myuzrilib/IndustrialDefectCPS-YOLOv8/hardware/station_layout.png

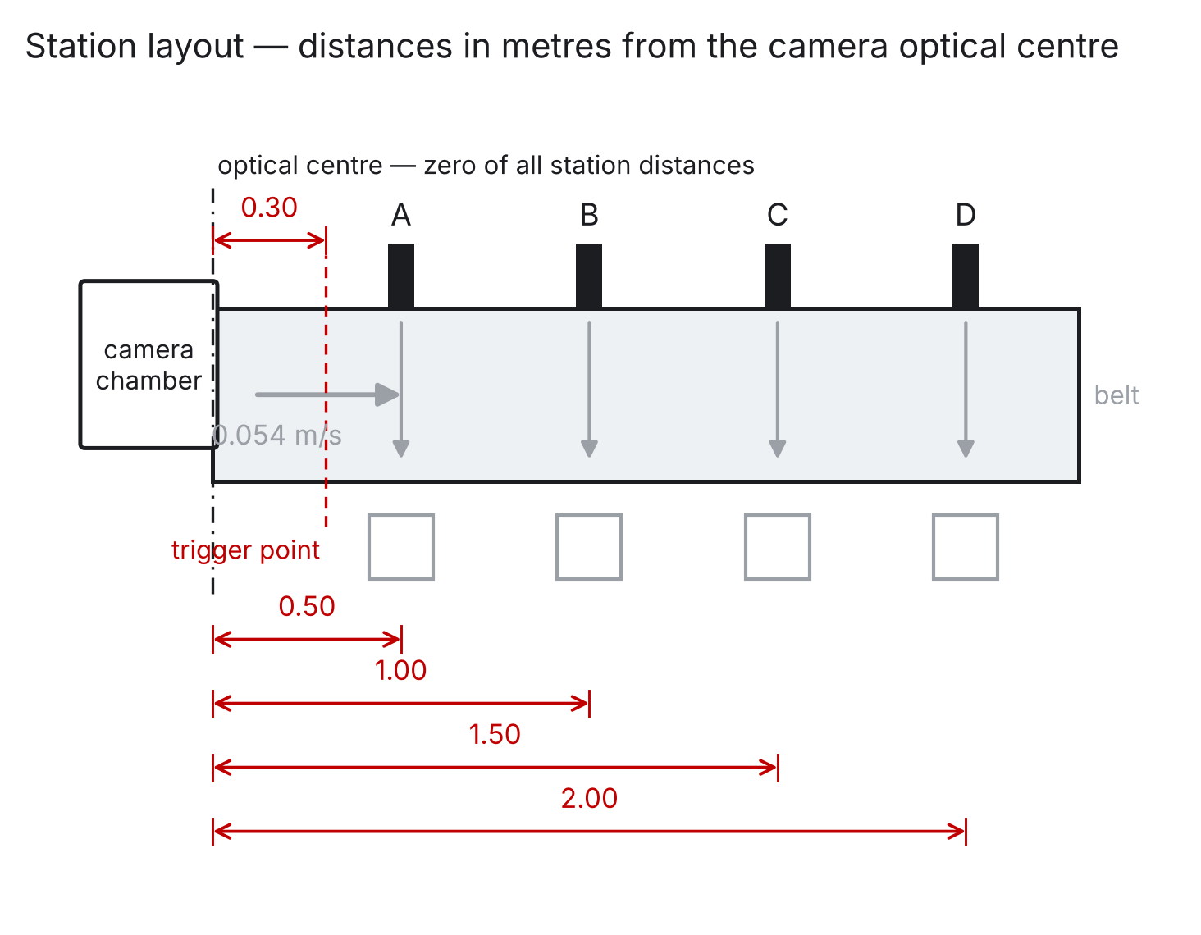
hardware/station_layout.png
