myuzrilib/IndustrialDefectCPS-YOLOv8/hardware/part_a_servo_pvc.stl

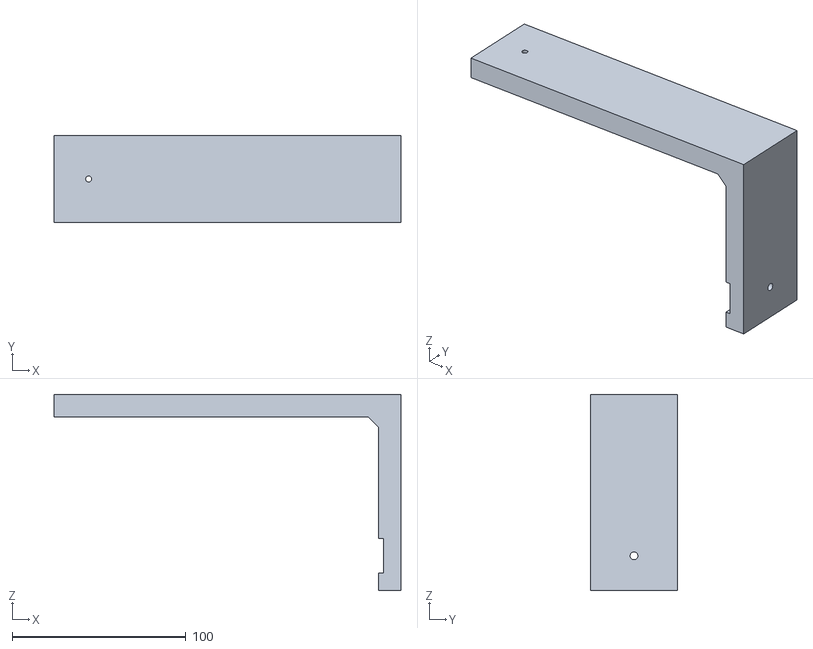
[picture p6: CAD file, 2026-10-29]
hardware/part_a_servo_pvc.stl
200.0 x 50.0 x 113.0
