myuzrilib/IndustrialDefectCPS-YOLOv8/hardware/part_b_conveyor_post.stl

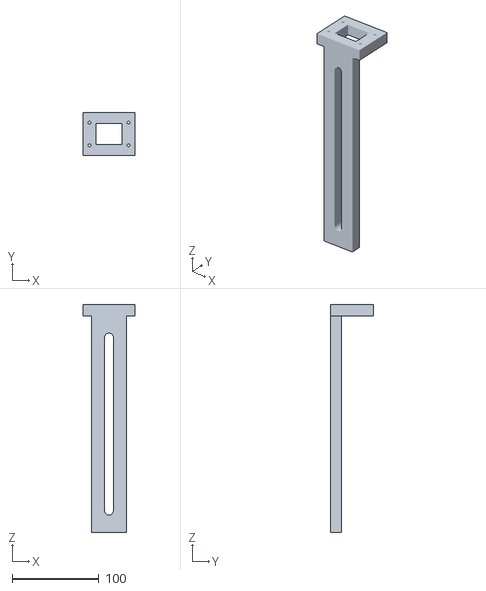
[picture p7: CAD file, 2026-10-29]
hardware/part_b_conveyor_post.stl
60.0 x 50.0 x 263.0
