myuzrilib/IndustrialDefectCPS-YOLOv8/hardware/wiring.png

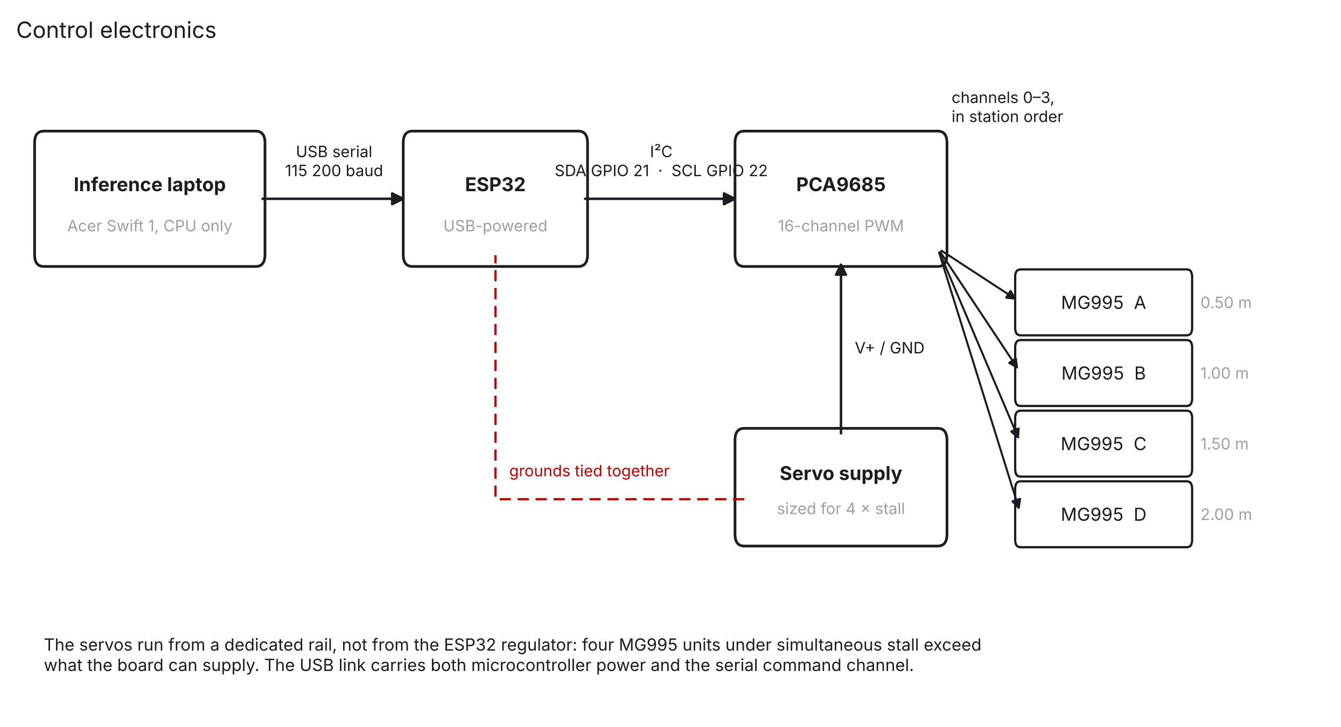
hardware/wiring.png
