myuzrilib/IndustrialDefectCPS-YOLOv8/IndustrialDefectCPS/results.png

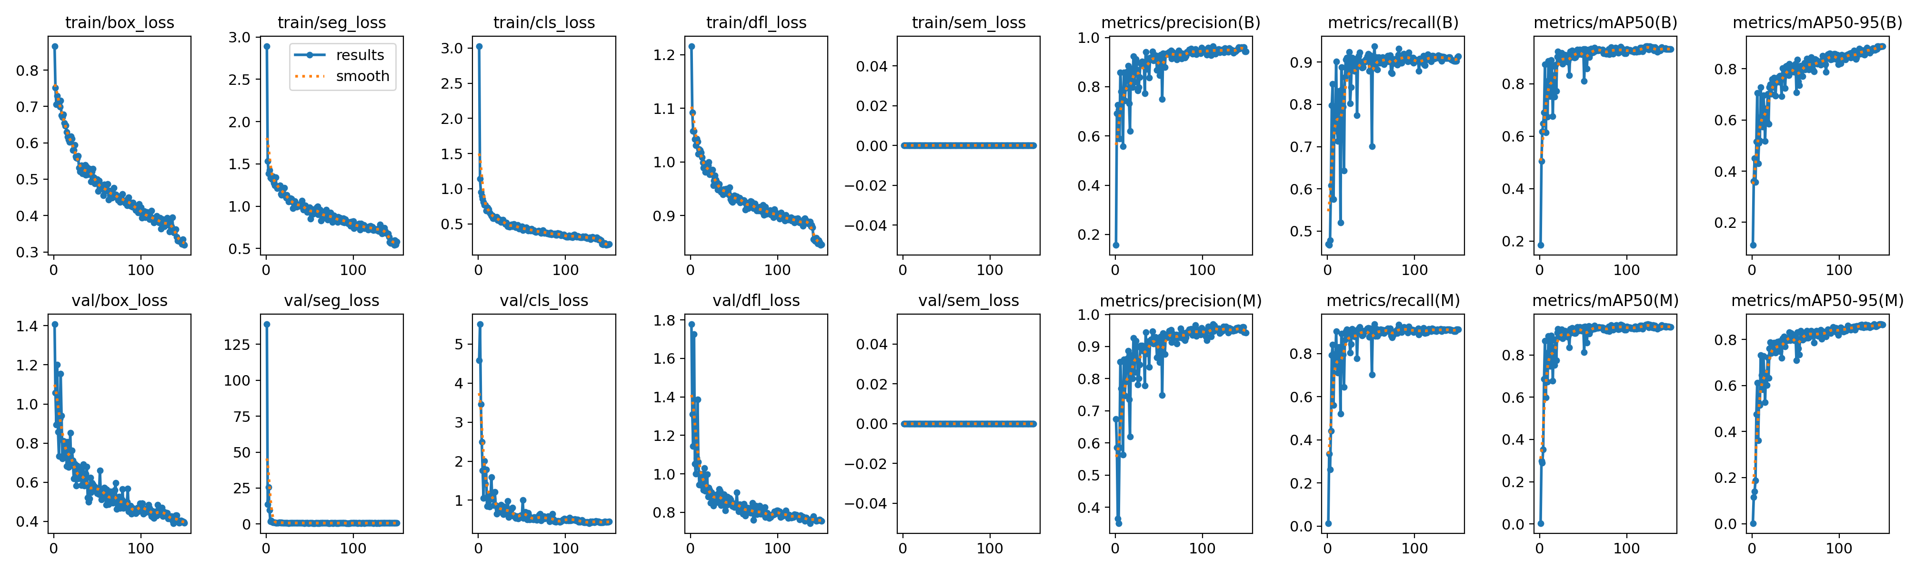
IndustrialDefectCPS/results.png
